aganus01/Team_40_Capstone_2024/KennethWeeklyReport.txt

9/19/23
This past week I researched to get a foundation in MCU programming
Looked at ESP32 WROVER datasheet and documents to see what model to use and to understand the devices
Downloaded VScode and installed ESP IDF extnesion and started looking at documentation
Plan on continuing to research and hopefully have the parts I need to order set before next week.
