aganus01/Team_40_Capstone_2024/(list of files, drawings)

Other design files:
1825910-6/1825910-6.SchLib
1825910-6/SW_1825910-6-4.PcbLib
AC0402KRX7R9BB103/AC0402KRX7R9BB103.SchLib
AC0402KRX7R9BB103/CAPC1005X55N.PcbLib
ADC.SchDoc
CurrentSense.SchDoc
ESP32.PcbLib
ESP32.SchLib
EthernetSheet.SchDoc
FlowDiagramRev2.SchDoc
Headers.SchDoc
HeatElement.SchDoc
McuOverview.SchDoc
MFR-25FBF52-1K/MFR-25FBF52-1K.SchLib
MFR-25FBF52-1K/RESAD1100W55L680D260.PcbLib
OverviewRev2.SchDoc
overviewSchematic.SchDoc
PCB1.PcbDoc
PCB-PartsFootprint.PcbLib
PCB-PartsSchematic.SchLib
PCB-Schematic.SchDoc
PCB_Project.PrjPcb
PESD5V0U1BA115.PcbLib
PESD5V0U1BA_115.SchLib
PowerFilters.SchDoc
RadationTestBoardMCU.SchDoc
t40MCUPCB.PcbDoc
Thermistor.SchDoc
TI_RTB_integrated1.PrjPcb
VRB.SchDoc
W5500/QFP50P900X900X160-48N.PcbLib
W5500/W5500.SchLib
